Lishayabou/team_drone/flight_controller/FC_BD.drawio.pdf

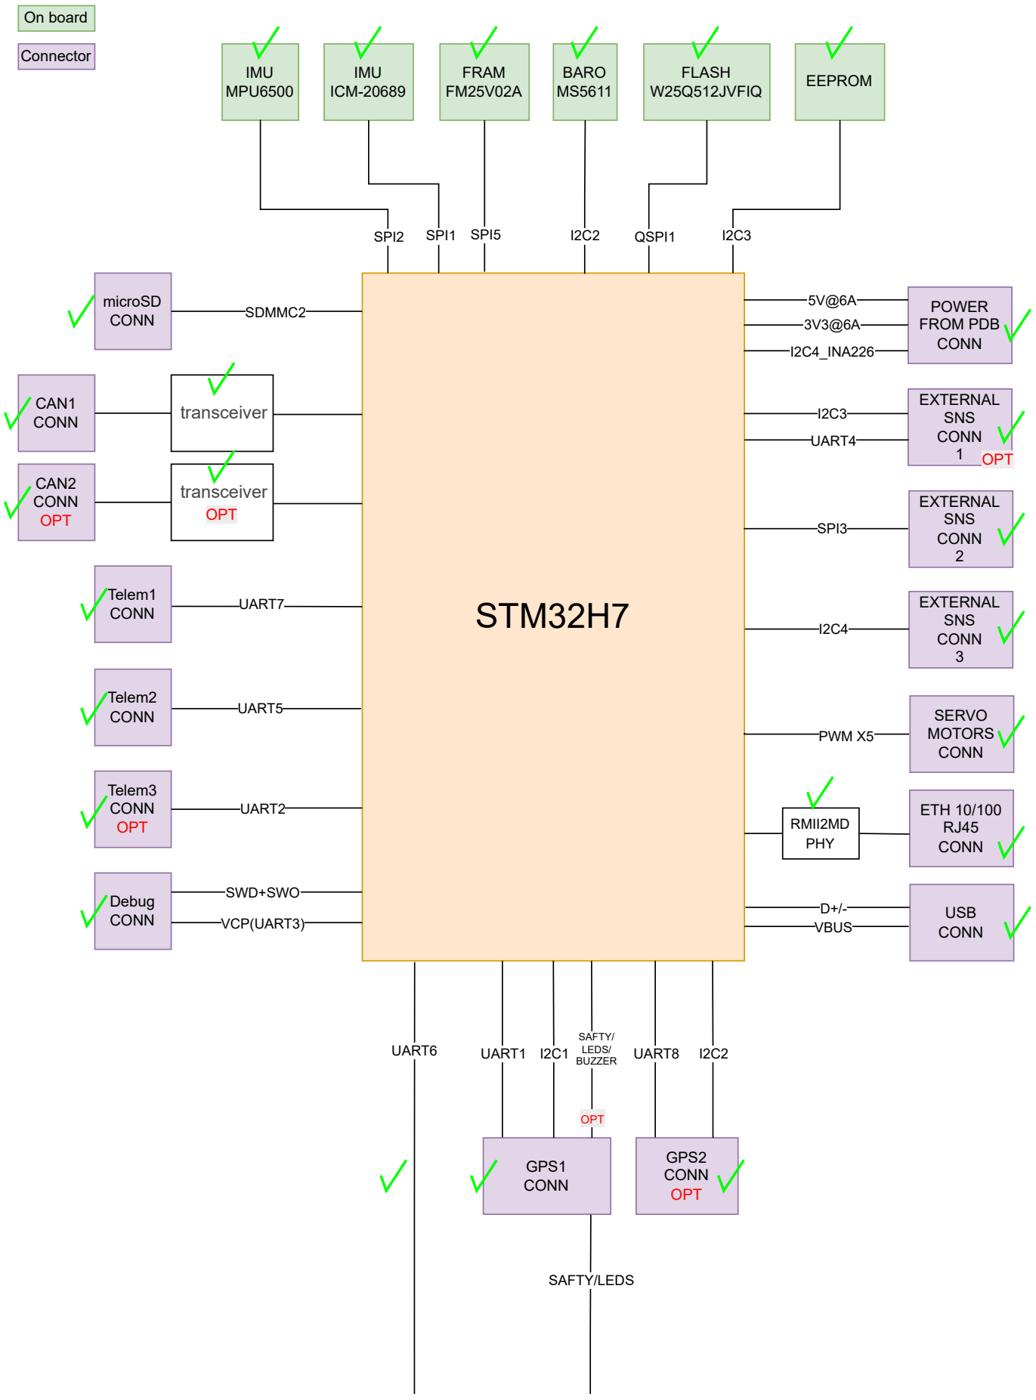
[picture p1: figure]
STM32H7; POWER FROM PDB CONN; IMU ICM-20689; IMU MPU6500; BARO MS5611; FRAM FM25V02A; microSD CONN; FLASH; W25Q512JVFIQ; EEPROM; SPI2; SPI1 SPI5; QSPI1; EXTERNAL SNS CONN 1; I2C4_INA226; Telem2 CONN; Telem1 CONN; Telem3 CONN OPT; SDMMC2; UART7; UART5; UART2; UART1; GPS1 CONN; SAFTY/ LEDS/; BUZZER; UART8; GPS2 CONN OPT; EXTERNAL SNS CONN 2; CAN1; CONN; transceiver; CAN2 CONN OPT; transceiver OPT; SERVO MOTORS CONN; USB CONN; UART4; SPI3; PWM X5; EXTERNAL SNS CONN 3; UART6; SAFTY/LEDS; Debug CONN; SWD+SWO; VCP(UART3); On board; Connector; ETH 10/100 RJ45 CONN; RMII2MD PHY; OPT; D+/- VBUS

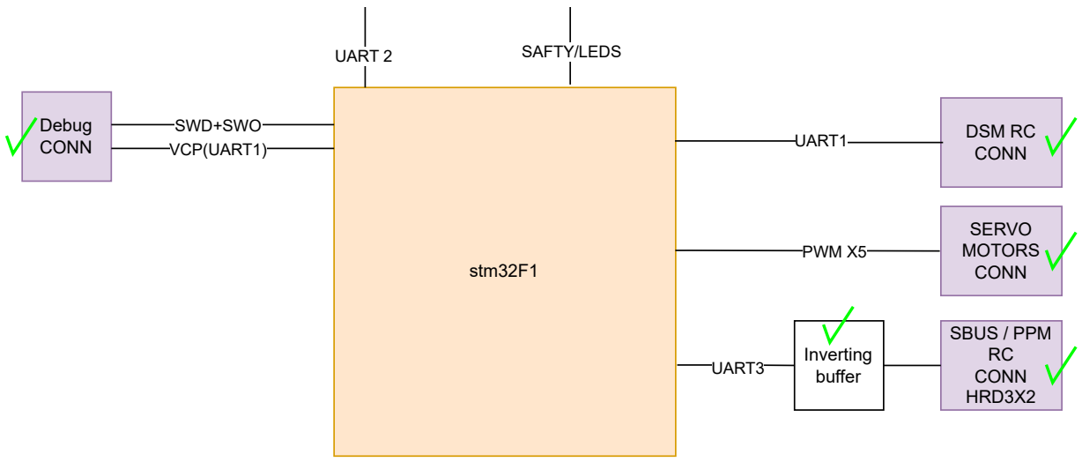
[picture p2: figure]
stm32F1; DSM RC CONN; UART1; SBUS / PPM RC CONN HRD3X2; Inverting buffer UART3; UART 2; SAFTY/LEDS; Debug CONN; SWD+SWO VCP(UART1); SERVO MOTORS CONN; PWM X5

OPEN ISSUES:
- reset from outside-> no
- nARMED signal from stm32-> TP
- TRACE SYNC SW 4 BIT -> no
- bootloader/vbus sense -> no
- NFC_GPIO -> TP
- HEATER for IMUs -> TP
- SPIX_SYNC-> no
- FMU_CAP1 (input pwm capture)-> TP
- sens for 3v3 & 5v-> no
- DSM -> for VCP
- USB_TYPE_C_SENSE from power-> no
- BEC - Battery Eliminator Circuit (separete 5v for servo) -> no
- ETH conn is RJ45
- 4 holes are added
- test points
- USB
