Lishayabou/team_drone/flight_controller/FP_BOARD.kicad_sch

## KiCad design flight_controller/FP_BOARD.kicad_sch (2026-02-17)

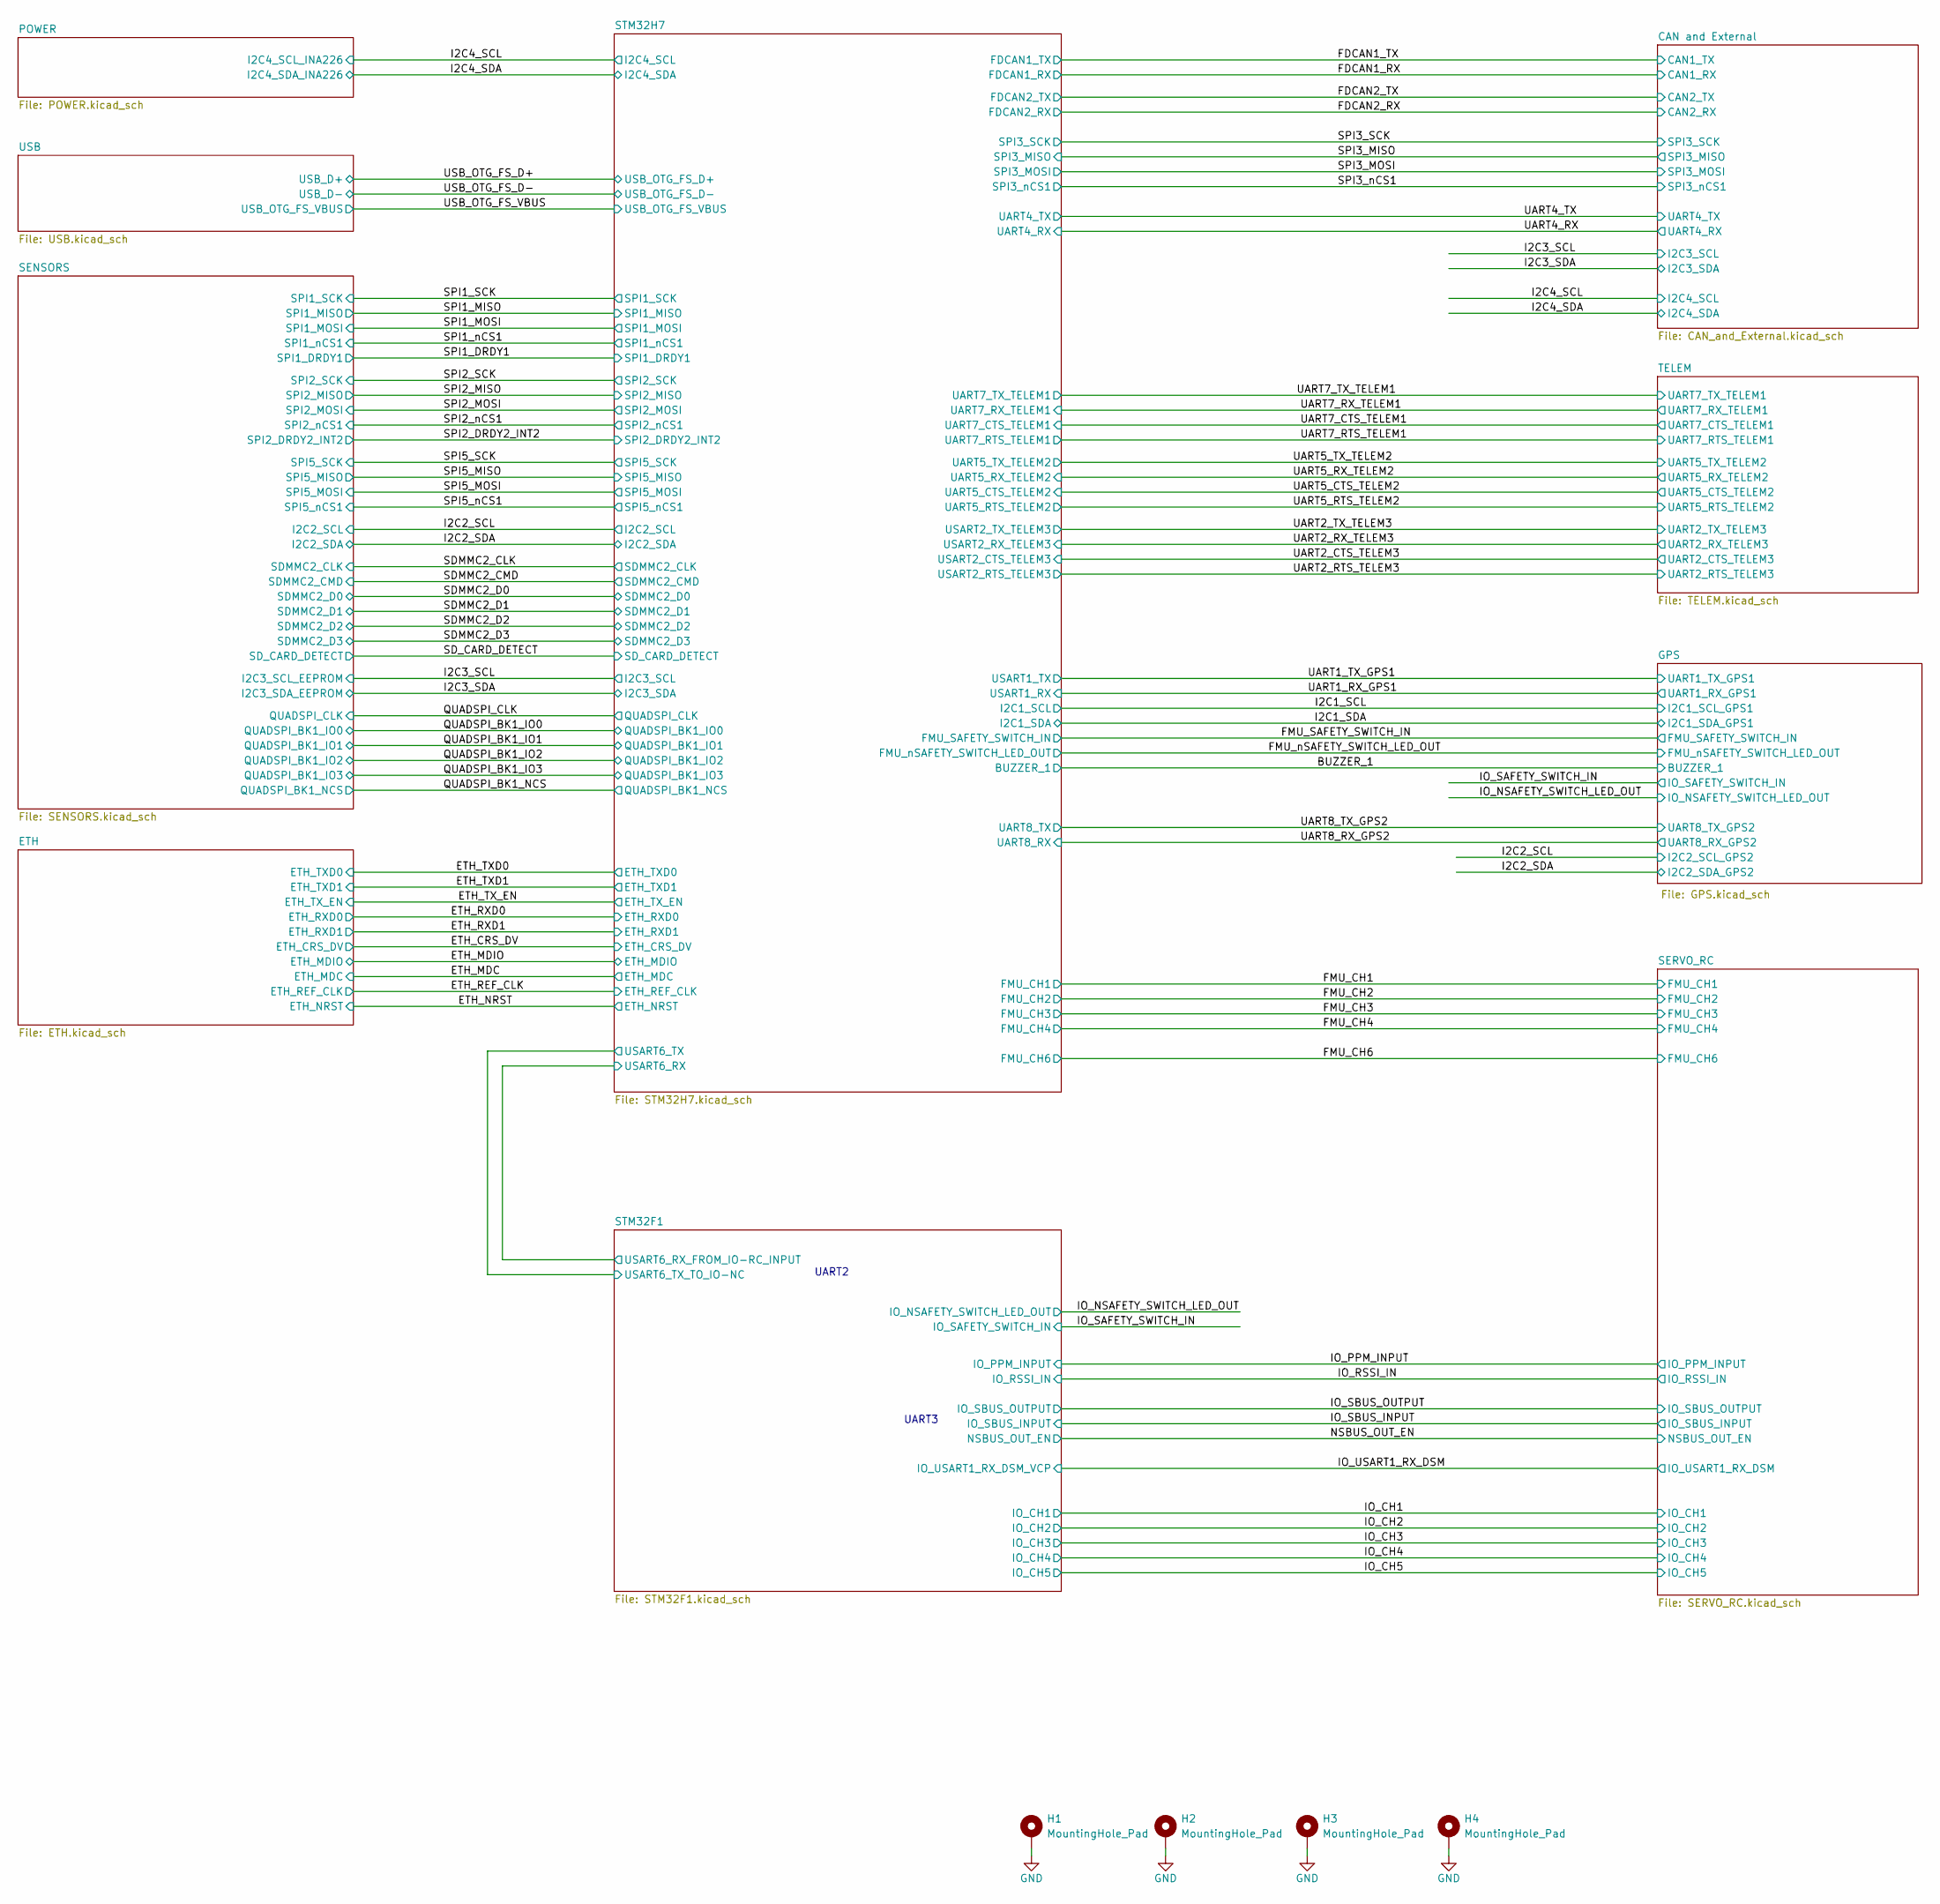
[picture p3: schematic FP_BOARD.kicad_sch]

Parts:
H1, H2, H3, H4: MountingHole_Pad; MountingHole_2.2mm_M2_Pad

Connections:
GND: H1.1, H2.1, H3.1, H4.1

Notes on the sheet:
UART2
UART3
