Lishayabou/team_drone/flight_controller/POWER.kicad_sch

## KiCad design flight_controller/POWER.kicad_sch (2026-02-17)

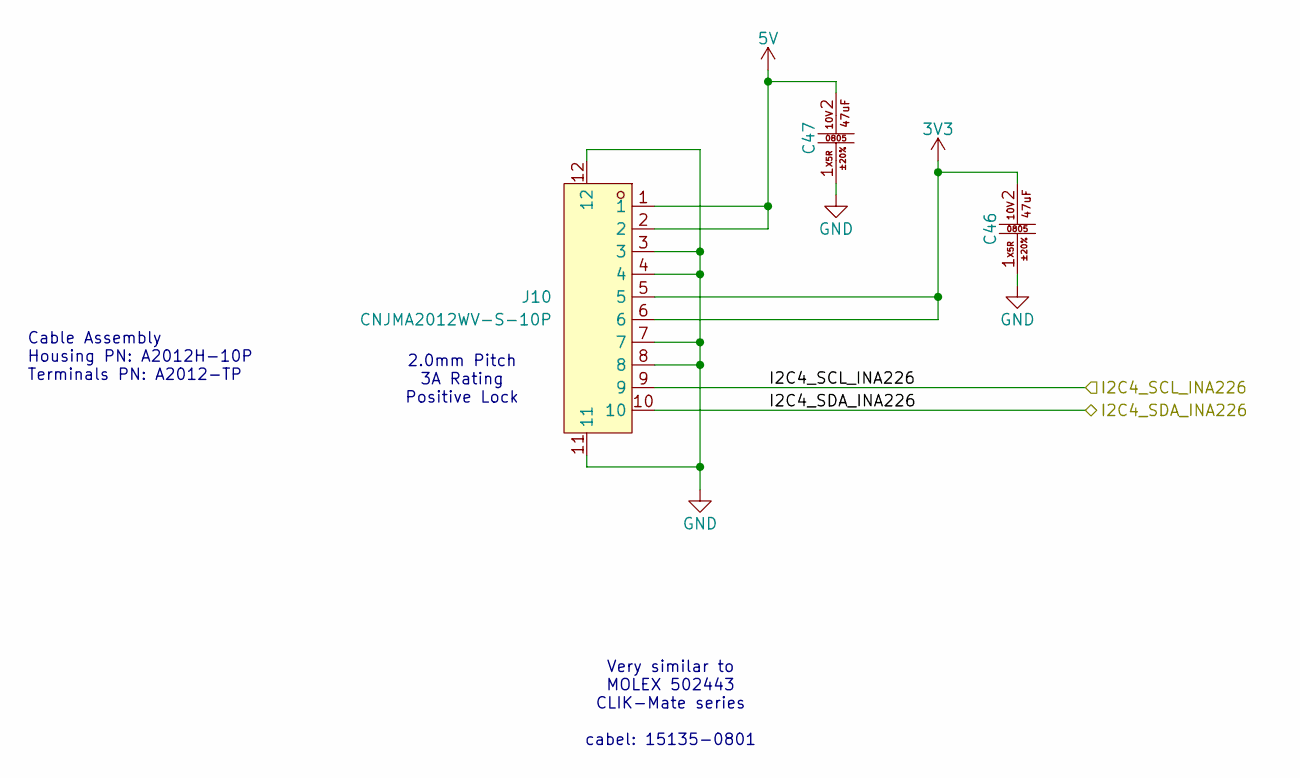
[picture p4: schematic POWER.kicad_sch]

Parts:
C46, C47: GRM21BR61A476ME15L (47uF , 0805 ,10V ,X5R); C0805; LCSC Part C124129
J10: CNJMA2012WV-S-10P; CONN-SMD_10P-P1.25_CNJM_CNJMA2012WV-S-10P; LCSC Part C5151225

Connections:
3V3: C46.2, J10.5, J10.6
5V: C47.2, J10.1, J10.2
GND: C46.1, C47.1, J10.3, J10.4, J10.7, J10.8, J10.11, J10.12
I2C4_SCL_INA226: J10.9
I2C4_SDA_INA226: J10.10

Notes on the sheet:
Cable Assembly Housing PN: A2012H-10P Terminals PN: A2012-TP
Very similar to MOLEX 502443 CLIK-Mate series cabel: 15135-0801
2.0mm Pitch 3A Rating Positive Lock
