Lishayabou/team_drone/flight_controller/STM32H7.kicad_sch

## KiCad design flight_controller/STM32H7.kicad_sch (2026-02-17)

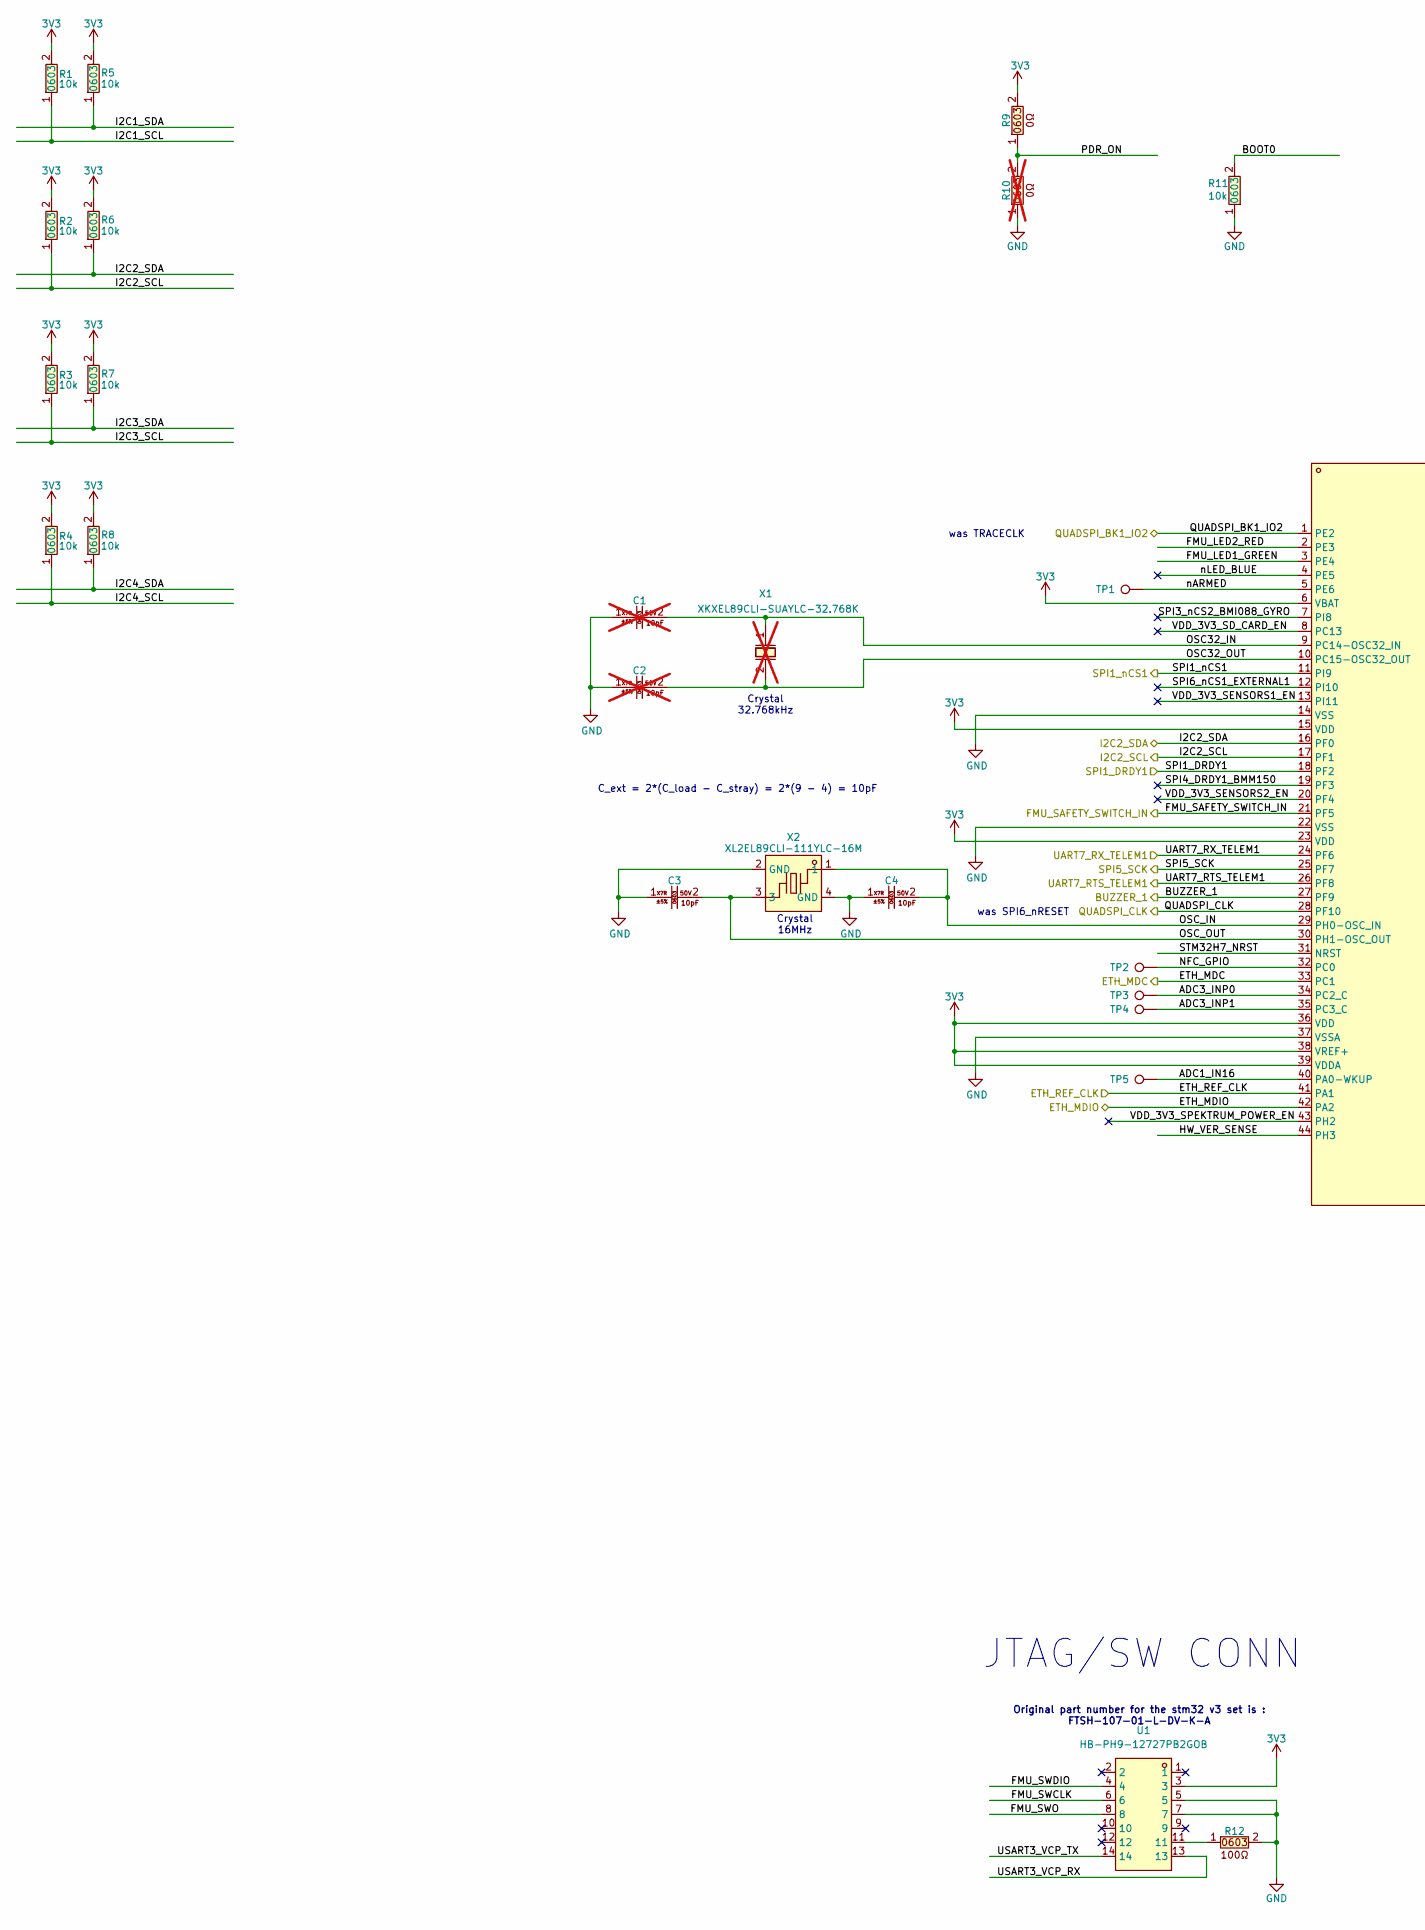
[picture p5: schematic STM32H7.kicad_sch, part in row 1, column 1]

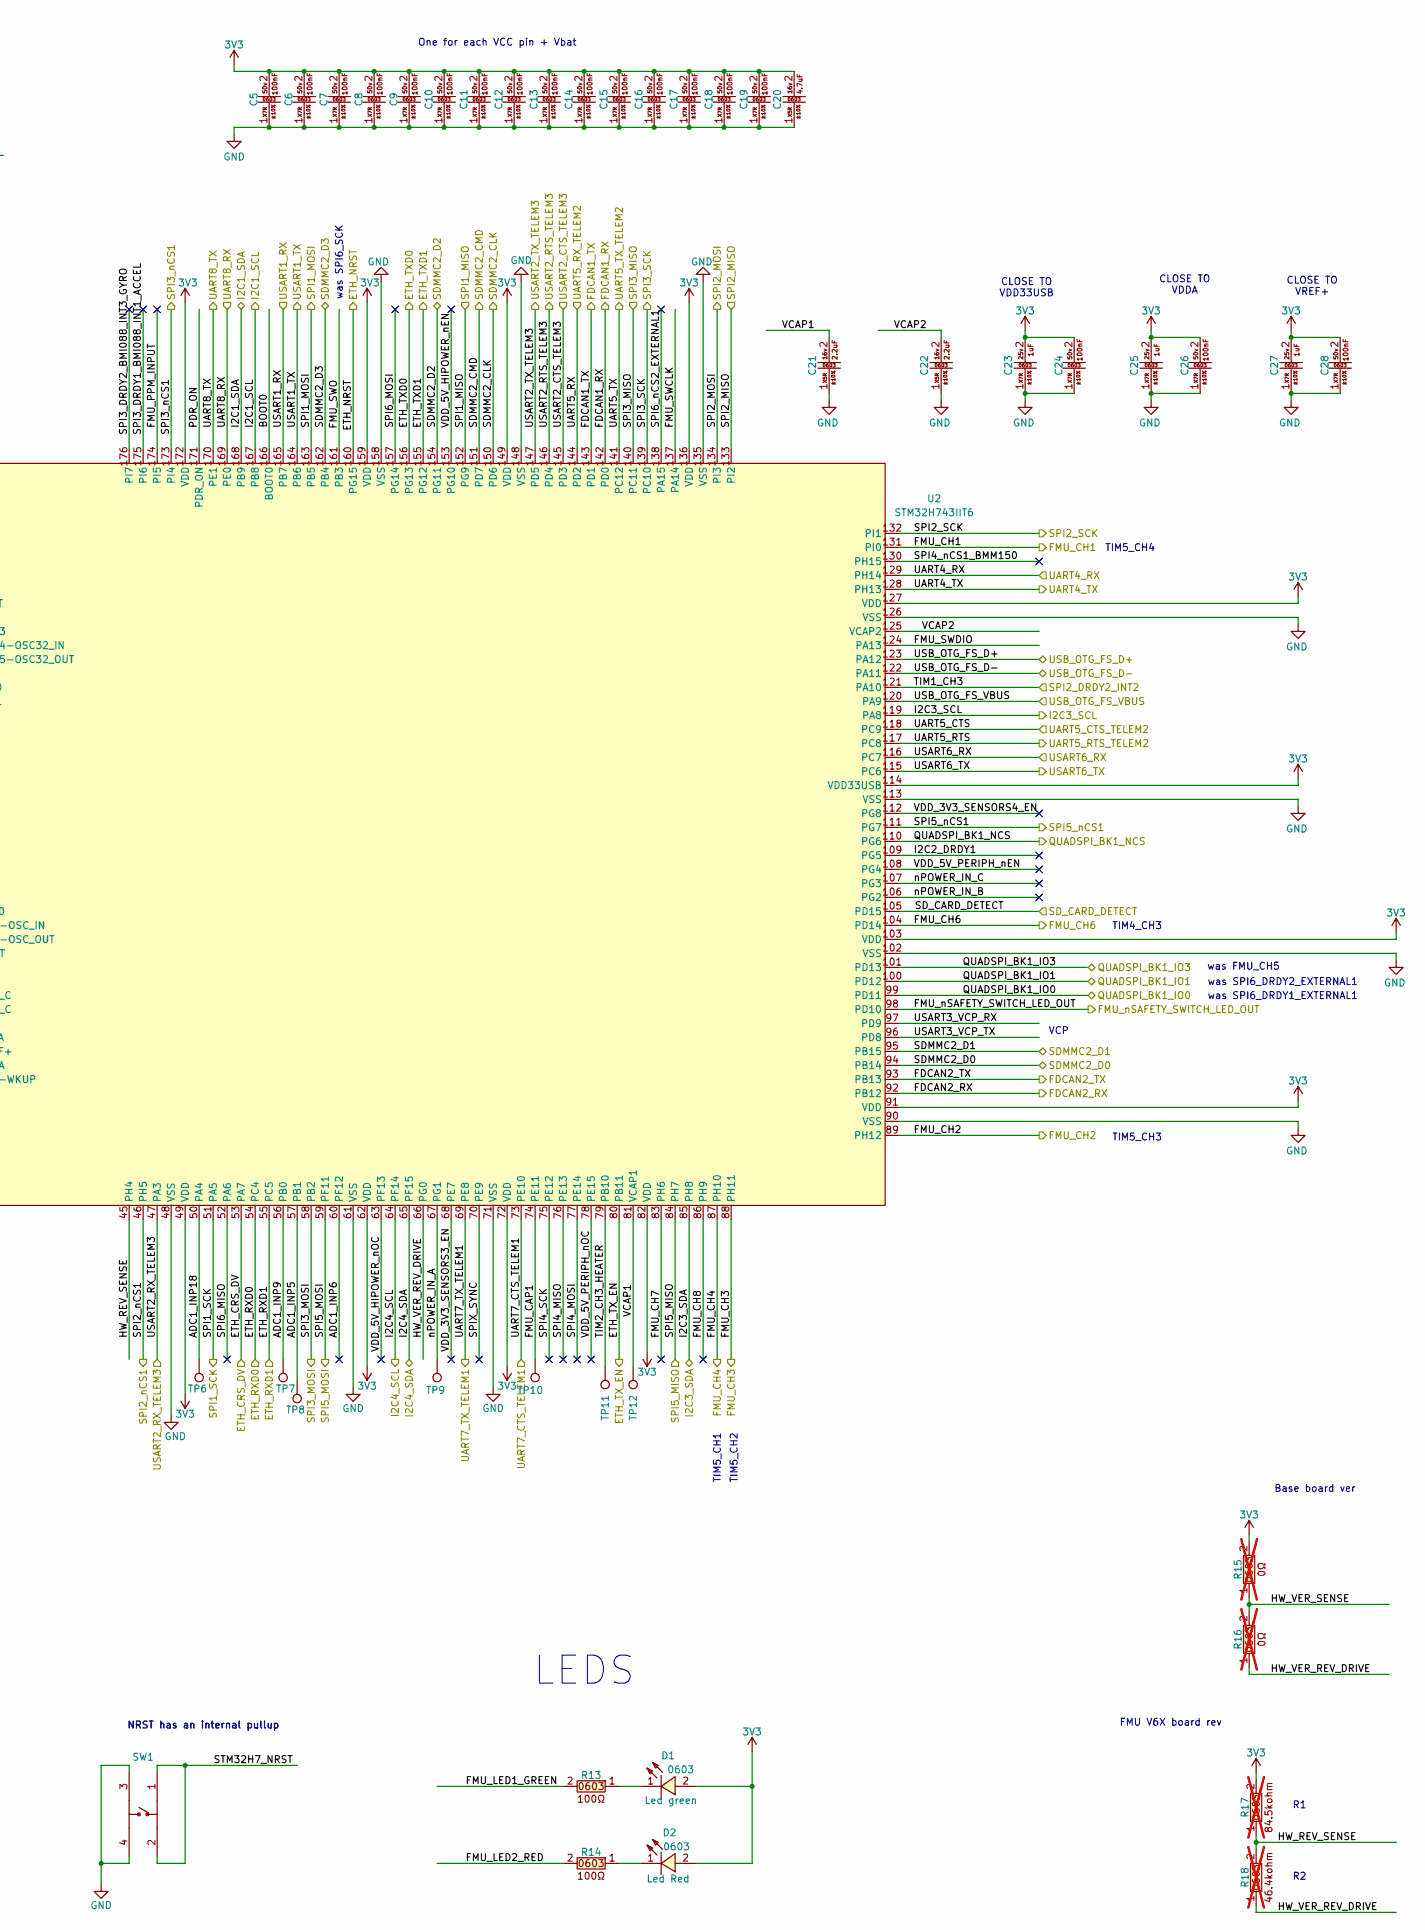
[picture p6: schematic STM32H7.kicad_sch, part in row 1, column 2]

Parts:
C1, C2: CC0603JRNPO9BN100 (10pF , 0603 ,50V ,X7R); C0603; LCSC Part C106245; not fitted
C3, C4: CC0603JRNPO9BN100 (10pF , 0603 ,50V ,X7R); C0603; LCSC Part C106245
C5, C6, C7, C8, C9, C10, C11, C12, C13, C14, C15, C16, C17, C18, C19, C24, C26, C28: CC0603KRX7R9BB104 (100nf , 0603 ,50v ,X7R); C0603; LCSC Part C14663
C20: CL10A475KO8NNNC (4.7uf , 0603 ,16v ,X5R); C0603; LCSC Part C19666
C21, C22: CL10A225KO8NNNC (2.2uf , 0603,16v,X5R); C0603; LCSC Part C23630
C23, C25, C27: CL10B105KA8NNNC (1uf ,0603 ,25v ,X7R); C0603; LCSC Part C29936
D1: 0603 Green 509-620mcd; LED0603-RD; LCSC Part C12624
D2: KT-0603R; LED0603-RD; LCSC Part C2286
R1, R2, R3, R4, R5, R6, R7, R8, R11: 0603WAF1002T5E; R0603; LCSC Part C25804
R9: 603WAF0000T5E (0ohm , 0603); R0603; LCSC Part C21189
R10, R15, R16: 603WAF0000T5E (0ohm , 0603); R0603; LCSC Part C21189; not fitted
R12, R13, R14: 603WAF1000T5E (100ohm , 0603); R0603; LCSC Part C22775
R17: 0603WAF8452T5E (84.5kohm , 0603); R0603; LCSC Part C23118; not fitted
R18: FRC0603F4642TS (46.4kohm , 0603); R0603; LCSC Part C3013203; not fitted
SW1: 6.0*6.0*6.0; SW-SMD_4P-L6.0-W6.0-P4.50-LS8.6; LCSC Part C5127964
TP1, TP2, TP3, TP4, TP5, TP6, TP7, TP8, TP9, TP10, TP11, TP12: TestPoint; TestPoint_Pad_2.0x2.0mm
U1: HB-PH9-12727PB2GOB; HDR-SMD_14P-P1.27-V-M-R2-C7-LS5.5; LCSC Part C6332251
U2: STM32H743IIT6; LQFP-176_L24.0-W24.0-P0.50-LS26.0-BL; LCSC Part C89597
X1: XKXEL89CLI-SUAYLC-32.768K; OSC-SMD_2P-L3.2-W1.5; LCSC Part C17179430; not fitted
X2: XL2EL89CLI-111YLC-16M; CRYSTAL-SMD_4P-L3.2-W2.5-BL; LCSC Part C5444547

Connections:
3V3: C5.2, C6.2, C7.2, C8.2, C9.2, C10.2, C11.2, C12.2, C13.2, C14.2, C15.2, C16.2, C17.2, C18.2, C19.2, C20.2, C23.2, C24.2, C25.2, C26.2, C27.2, C28.2, D1.2 (A), D2.2 (A), R1.2, R2.2, R3.2, R4.2, R5.2, R6.2, R7.2, R8.2, R9.2, R15.2, R17.2, U1.3, U2.6 (VBAT), U2.15 (VDD), U2.23 (VDD), U2.36 (VDD), U2.38 (VREF+), U2.39 (VDDA), U2.49 (VDD), U2.62 (VDD), U2.72 (VDD), U2.82 (VDD), U2.91 (VDD), U2.103 (VDD), U2.114 (VDD33USB), U2.127 (VDD), U2.136 (VDD), U2.149 (VDD), U2.159 (VDD), U2.172 (VDD)
ADC1_IN16: TP5.1, U2.40 (PA0-WKUP)
ADC1_INP5: TP8.1, U2.57 (PB1)
ADC1_INP6: U2.60 (PF12)
ADC1_INP9: TP7.1, U2.56 (PB0)
ADC1_INP18: TP6.1, U2.50 (PA4)
ADC3_INP0: TP3.1, U2.34 (PC2_C)
ADC3_INP1: TP4.1, U2.35 (PC3_C)
BOOT0: R11.2, U2.166 (BOOT0)
BUZZER_1: U2.27 (PF9)
ETH_CRS_DV: U2.53 (PA7)
ETH_MDC: U2.33 (PC1)
ETH_MDIO: U2.42 (PA2)
ETH_NRST: U2.160 (PG15)
ETH_REF_CLK: U2.41 (PA1)
ETH_RXD0: U2.54 (PC4)
ETH_RXD1: U2.55 (PC5)
ETH_TXD0: U2.156 (PG13)
ETH_TXD1: U2.155 (PG12)
ETH_TX_EN: U2.80 (PB11)
FDCAN1_RX: U2.142 (PD0)
FDCAN1_TX: U2.143 (PD1)
FDCAN2_RX: U2.92 (PB12)
FDCAN2_TX: U2.93 (PB13)
FMU_CAP1: TP10.1, U2.74 (PE11)
FMU_CH1: U2.131 (PI0)
FMU_CH2: U2.89 (PH12)
FMU_CH3: U2.88 (PH11)
FMU_CH4: U2.87 (PH10)
FMU_CH6: U2.104 (PD14)
FMU_CH7: U2.83 (PH6)
FMU_CH8: U2.86 (PH9)
FMU_LED1_GREEN: R13.2, U2.3 (PE4)
FMU_LED2_RED: R14.2, U2.2 (PE3)
FMU_PPM_INPUT: U2.174 (PI5)
FMU_SAFETY_SWITCH_IN: U2.21 (PF5)
FMU_SWCLK: U1.6, U2.137 (PA14)
FMU_SWDIO: U1.4, U2.124 (PA13)
FMU_SWO: U1.8, U2.161 (PB3)
FMU_nSAFETY_SWITCH_LED_OUT: U2.98 (PD10)
GND: C1.1, C2.1, C3.1, C4.1, C5.1, C6.1, C7.1, C8.1, C9.1, C10.1, C11.1, C12.1, C13.1, C14.1, C15.1, C16.1, C17.1, C18.1, C19.1, C20.1, C21.1, C22.1, C23.1, C24.1, C25.1, C26.1, C27.1, C28.1, R10.1, R11.1, R12.2, SW1.3, SW1.4, U1.5, U1.7, U2.14 (VSS), U2.22 (VSS), U2.37 (VSSA), U2.48 (VSS), U2.61 (VSS), U2.71 (VSS), U2.90 (VSS), U2.102 (VSS), U2.113 (VSS), U2.126 (VSS), U2.135 (VSS), U2.148 (VSS), U2.158 (VSS), X2.2 (GND), X2.4 (GND)
HW_REV_SENSE: R17.1, R18.2, U2.45 (PH4)
HW_VER_REV_DRIVE: R16.1, R18.1, U2.66 (PG0)
HW_VER_SENSE: R15.1, R16.2, U2.44 (PH3)
I2C1_SCL: R1.1, U2.167 (PB8)
I2C1_SDA: R5.1, U2.168 (PB9)
I2C2_DRDY1: U2.109 (PG5)
I2C2_SCL: R2.1, U2.17 (PF1)
I2C2_SDA: R6.1, U2.16 (PF0)
I2C3_SCL: R3.1, U2.119 (PA8)
I2C3_SDA: R7.1, U2.85 (PH8)
I2C4_SCL: R4.1, U2.64 (PF14)
I2C4_SDA: R8.1, U2.65 (PF15)
NFC_GPIO: TP2.1, U2.32 (PC0)
unnamed: D1.1 (K), R13.1
unnamed: D2.1 (K), R14.1
unnamed: R12.1, U1.11
OSC32_IN: C1.2, U2.9 (PC14-OSC32_IN), X1.1
OSC32_OUT: C2.2, U2.10 (PC15-OSC32_OUT), X1.2
OSC_IN: C4.2, U2.29 (PH0-OSC_IN), X2.1
OSC_OUT: C3.2, U2.30 (PH1-OSC_OUT), X2.3
PDR_ON: R9.1, R10.2, U2.171 (PDR_ON)
QUADSPI_BK1_IO0: U2.99 (PD11)
QUADSPI_BK1_IO1: U2.100 (PD12)
QUADSPI_BK1_IO2: U2.1 (PE2)
QUADSPI_BK1_IO3: U2.101 (PD13)
QUADSPI_BK1_NCS: U2.110 (PG6)
QUADSPI_CLK: U2.28 (PF10)
SDMMC2_CLK: U2.150 (PD6)
SDMMC2_CMD: U2.151 (PD7)
SDMMC2_D0: U2.94 (PB14)
SDMMC2_D1: U2.95 (PB15)
SDMMC2_D2: U2.154 (PG11)
SDMMC2_D3: U2.162 (PB4)
SD_CARD_DETECT: U2.105 (PD15)
SPI1_DRDY1: U2.18 (PF2)
SPI1_MISO: U2.152 (PG9)
SPI1_MOSI: U2.163 (PB5)
SPI1_SCK: U2.51 (PA5)
SPI1_nCS1: U2.11 (PI9)
SPI2_DRDY2_INT2: U2.121 (PA10)
SPI2_MISO: U2.133 (PI2)
SPI2_MOSI: U2.134 (PI3)
SPI2_SCK: U2.132 (PI1)
SPI2_nCS1: U2.46 (PH5)
SPI3_DRDY1_BMI088_INT1_ACCEL: U2.175 (PI6)
SPI3_DRDY2_BMI088_INT3_GYRO: U2.176 (PI7)
SPI3_MISO: U2.140 (PC11)
SPI3_MOSI: U2.58 (PB2)
SPI3_SCK: U2.139 (PC10)
SPI3_nCS1: U2.173 (PI4)
SPI3_nCS2_BMI088_GYRO: U2.7 (PI8)
SPI4_DRDY1_BMM150: U2.19 (PF3)
SPI4_MISO: U2.76 (PE13)
SPI4_MOSI: U2.77 (PE14)
SPI4_SCK: U2.75 (PE12)
SPI4_nCS1_BMM150: U2.130 (PH15)
SPI5_MISO: U2.84 (PH7)
SPI5_MOSI: U2.59 (PF11)
SPI5_SCK: U2.25 (PF7)
SPI5_nCS1: U2.111 (PG7)
SPI6_MISO: U2.52 (PA6)
SPI6_MOSI: U2.157 (PG14)
SPI6_nCS1_EXTERNAL1: U2.12 (PI10)
SPI6_nCS2_EXTERNAL1: U2.138 (PA15)
SPIX_SYNC: U2.70 (PE9)
STM32H7_NRST: SW1.1, SW1.2, U2.31 (NRST)
TIM2_CH3_HEATER: TP11.1, U2.79 (PB10)
UART4_RX: U2.129 (PH14)
UART4_TX: U2.128 (PH13)
UART5_CTS: U2.118 (PC9)
UART5_RTS: U2.117 (PC8)
UART5_RX: U2.144 (PD2)
UART5_TX: U2.141 (PC12)
UART7_CTS_TELEM1: U2.73 (PE10)
UART7_RTS_TELEM1: U2.26 (PF8)
UART7_RX_TELEM1: U2.24 (PF6)
UART7_TX_TELEM1: U2.69 (PE8)
UART8_RX: U2.169 (PE0)
UART8_TX: U2.170 (PE1)
USART1_RX: U2.165 (PB7)
USART1_TX: U2.164 (PB6)
USART2_CTS_TELEM3: U2.145 (PD3)
USART2_RTS_TELEM3: U2.146 (PD4)
USART2_RX_TELEM3: U2.47 (PA3)
USART2_TX_TELEM3: U2.147 (PD5)
USART3_VCP_RX: U1.13, U2.97 (PD9)
USART3_VCP_TX: U1.14, U2.96 (PD8)
USART6_RX: U2.116 (PC7)
USART6_TX: U2.115 (PC6)
USB_OTG_FS_D+: U2.123 (PA12)
USB_OTG_FS_D-: U2.122 (PA11)
USB_OTG_FS_VBUS: U2.120 (PA9)
VCAP1: C21.2, TP12.1, U2.81 (VCAP1)
VCAP2: C22.2, U2.125 (VCAP2)
VDD_3V3_SD_CARD_EN: U2.8 (PC13)
VDD_3V3_SENSORS1_EN: U2.13 (PI11)
VDD_3V3_SENSORS2_EN: U2.20 (PF4)
VDD_3V3_SENSORS3_EN: U2.68 (PE7)
VDD_3V3_SENSORS4_EN: U2.112 (PG8)
VDD_3V3_SPEKTRUM_POWER_EN: U2.43 (PH2)
VDD_5V_HIPOWER_nEN: U2.153 (PG10)
VDD_5V_HIPOWER_nOC: U2.63 (PF13)
VDD_5V_PERIPH_nEN: U2.108 (PG4)
VDD_5V_PERIPH_nOC: U2.78 (PE15)
nARMED: TP1.1, U2.5 (PE6)
nLED_BLUE: U2.4 (PE5)
nPOWER_IN_A: TP9.1, U2.67 (PG1)
nPOWER_IN_B: U2.106 (PG2)
nPOWER_IN_C: U2.107 (PG3)

Notes on the sheet:
was SPI6_nRESET
Crystal 32.768kHz
was TRACECLK
C_ext = 2*(C_load - C_stray) = 2*(9 - 4) = 10pF
TIM4_CH3
CLOSE TO VDDA
CLOSE TO VREF+
LEDS
Original part number for the stm32 v3 set is : FTSH-107-01-L-DV-K-A
FMU V6X board rev
TIM5_CH1
NRST has an internal pullup
was FMU_CH5
Base board ver
Crystal 16MHz
TIM5_CH3
was SPI6_SCK
VCP
was SPI6_DRDY2_EXTERNAL1
TIM5_CH4
One for each VCC pin + Vbat
was SPI6_DRDY1_EXTERNAL1
JTAG/SW CONN
TIM5_CH2
CLOSE TO VDD33USB
