Lishayabou/team_drone/flight_controller/TELEM.kicad_sch

## KiCad design flight_controller/TELEM.kicad_sch (2026-02-17)

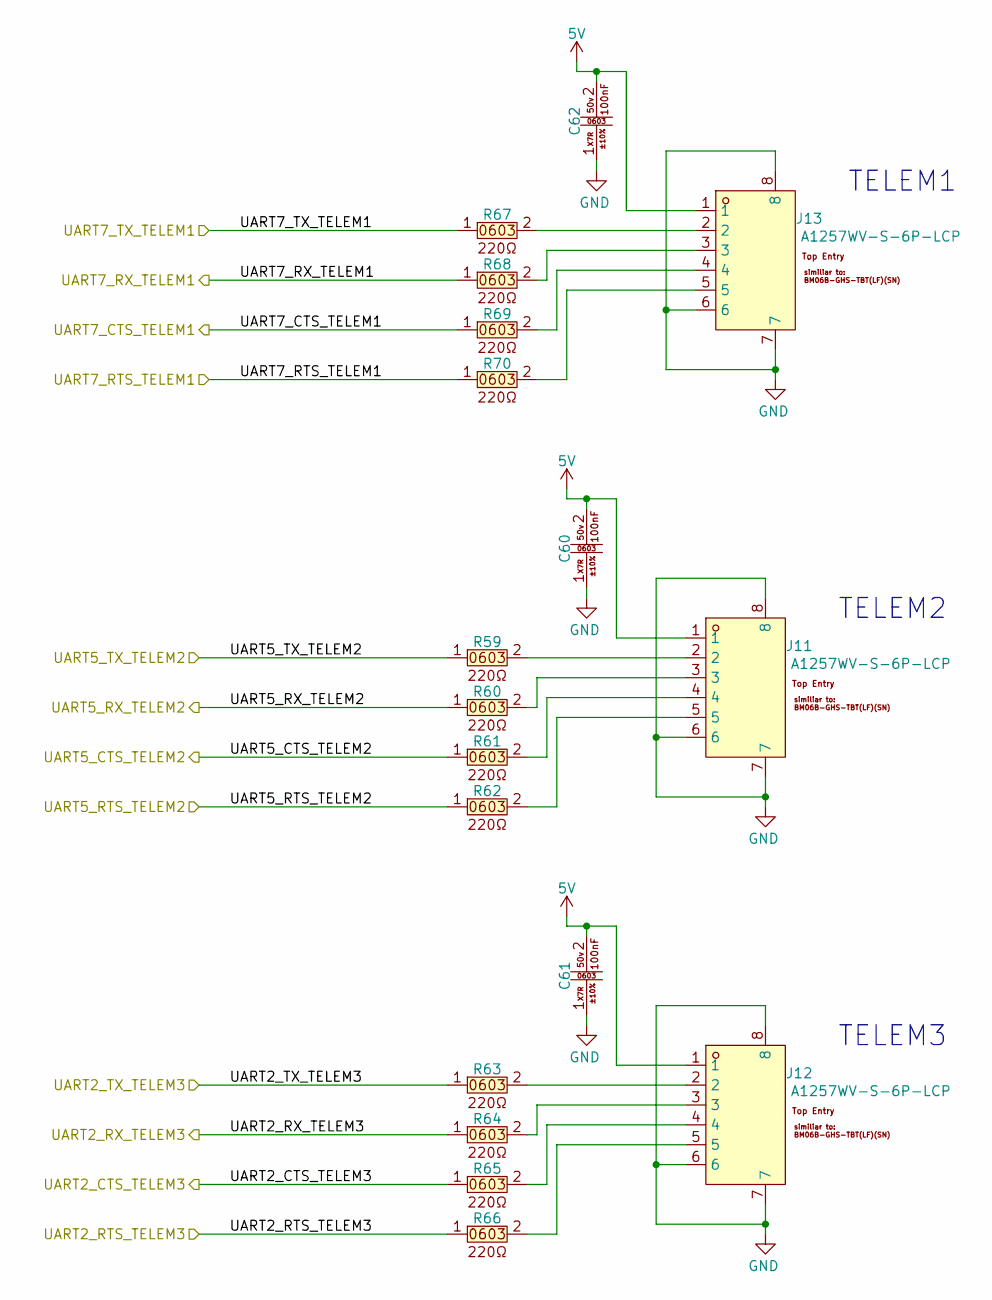
[picture p7: schematic TELEM.kicad_sch]

Parts:
C60, C61, C62: CC0603KRX7R9BB104 (100nf , 0603 ,50v ,X7R); C0603; LCSC Part C14663
J11, J12, J13: A1257WV-S-6P-LCP; CONN-SMD_A1257WV-S-6P; LCSC Part C225122
R59, R60, R61, R62, R63, R64, R65, R66, R67, R68, R69, R70: 0603WAF2200T5E (220ohm , 0603); R0603; LCSC Part C22962

Connections:
5V: C60.2, C61.2, C62.2, J11.1, J12.1, J13.1
GND: C60.1, C61.1, C62.1, J11.6, J11.7, J11.8, J12.6, J12.7, J12.8, J13.6, J13.7, J13.8
unnamed: J11.2, R59.2
unnamed: J11.3, R60.2
unnamed: J11.4, R61.2
unnamed: J11.5, R62.2
unnamed: J12.2, R63.2
unnamed: J12.3, R64.2
unnamed: J12.4, R65.2
unnamed: J12.5, R66.2
unnamed: J13.2, R67.2
unnamed: J13.3, R68.2
unnamed: J13.4, R69.2
unnamed: J13.5, R70.2
UART2_CTS_TELEM3: R65.1
UART2_RTS_TELEM3: R66.1
UART2_RX_TELEM3: R64.1
UART2_TX_TELEM3: R63.1
UART5_CTS_TELEM2: R61.1
UART5_RTS_TELEM2: R62.1
UART5_RX_TELEM2: R60.1
UART5_TX_TELEM2: R59.1
UART7_CTS_TELEM1: R69.1
UART7_RTS_TELEM1: R70.1
UART7_RX_TELEM1: R68.1
UART7_TX_TELEM1: R67.1

Notes on the sheet:
TELEM1
TELEM2
TELEM3
