Lishayabou/team_drone/flight_controller/USB.kicad_sch

## KiCad design flight_controller/USB.kicad_sch (2026-02-17)

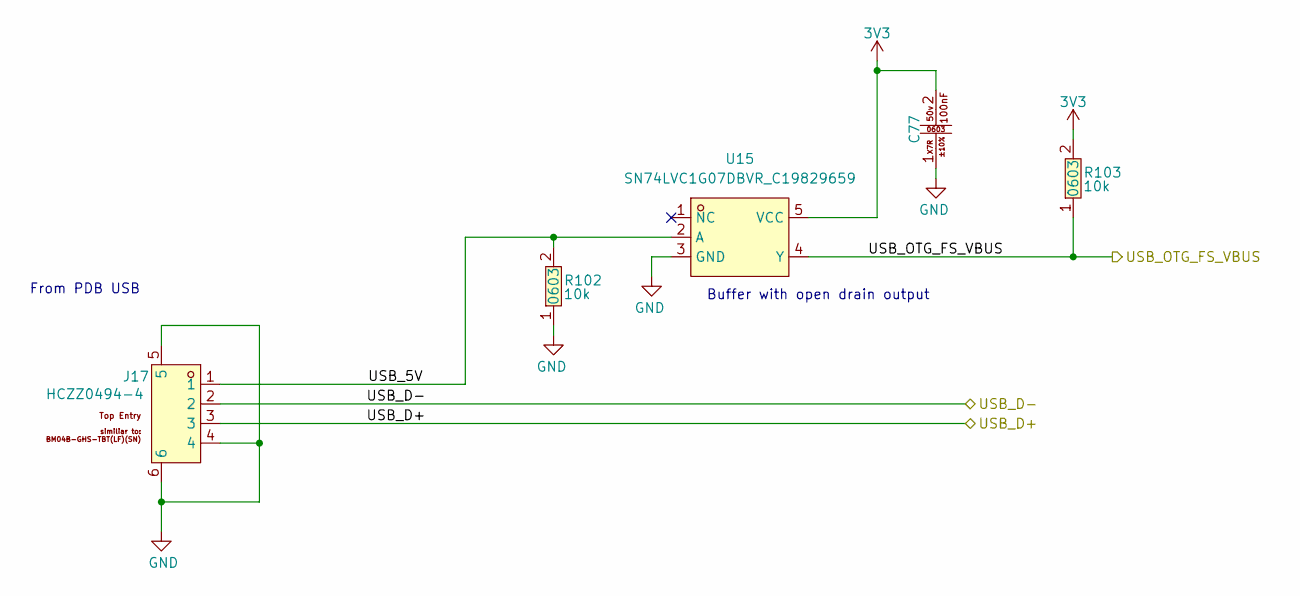
[picture p8: schematic USB.kicad_sch]

Parts:
C77: CC0603KRX7R9BB104 (100nf , 0603 ,50v ,X7R); C0603; LCSC Part C14663
J17: HCZZ0494-4; CONN-SMD_4P-P1.25_BM04B-GHS-TBT-LF-SN; LCSC Part C7433500
R102, R103: 0603WAF1002T5E; R0603; LCSC Part C25804
U15: SN74LVC1G07DBVR_C19829659; SOT-23-5_L3.0-W1.5-P0.95-LS2.8-BL; LCSC Part C19829659

Connections:
3V3: C77.2, R103.2, U15.5 (VCC)
GND: C77.1, J17.4, J17.5, J17.6, R102.1, U15.3 (GND)
USB_5V: J17.1, R102.2, U15.2 (A)
USB_D+: J17.3
USB_D-: J17.2
USB_OTG_FS_VBUS: R103.1, U15.4 (Y)

Notes on the sheet:
From PDB USB
Buffer with open drain output
